XyrusB2010/XYmatics-Alpha/(list of files, cad)

Other CAD files:
CAD/XYmatics-Alpha.f3d
