XyrusB2010/XYmatics-Alpha/PCB/xymatics-e64.pdf

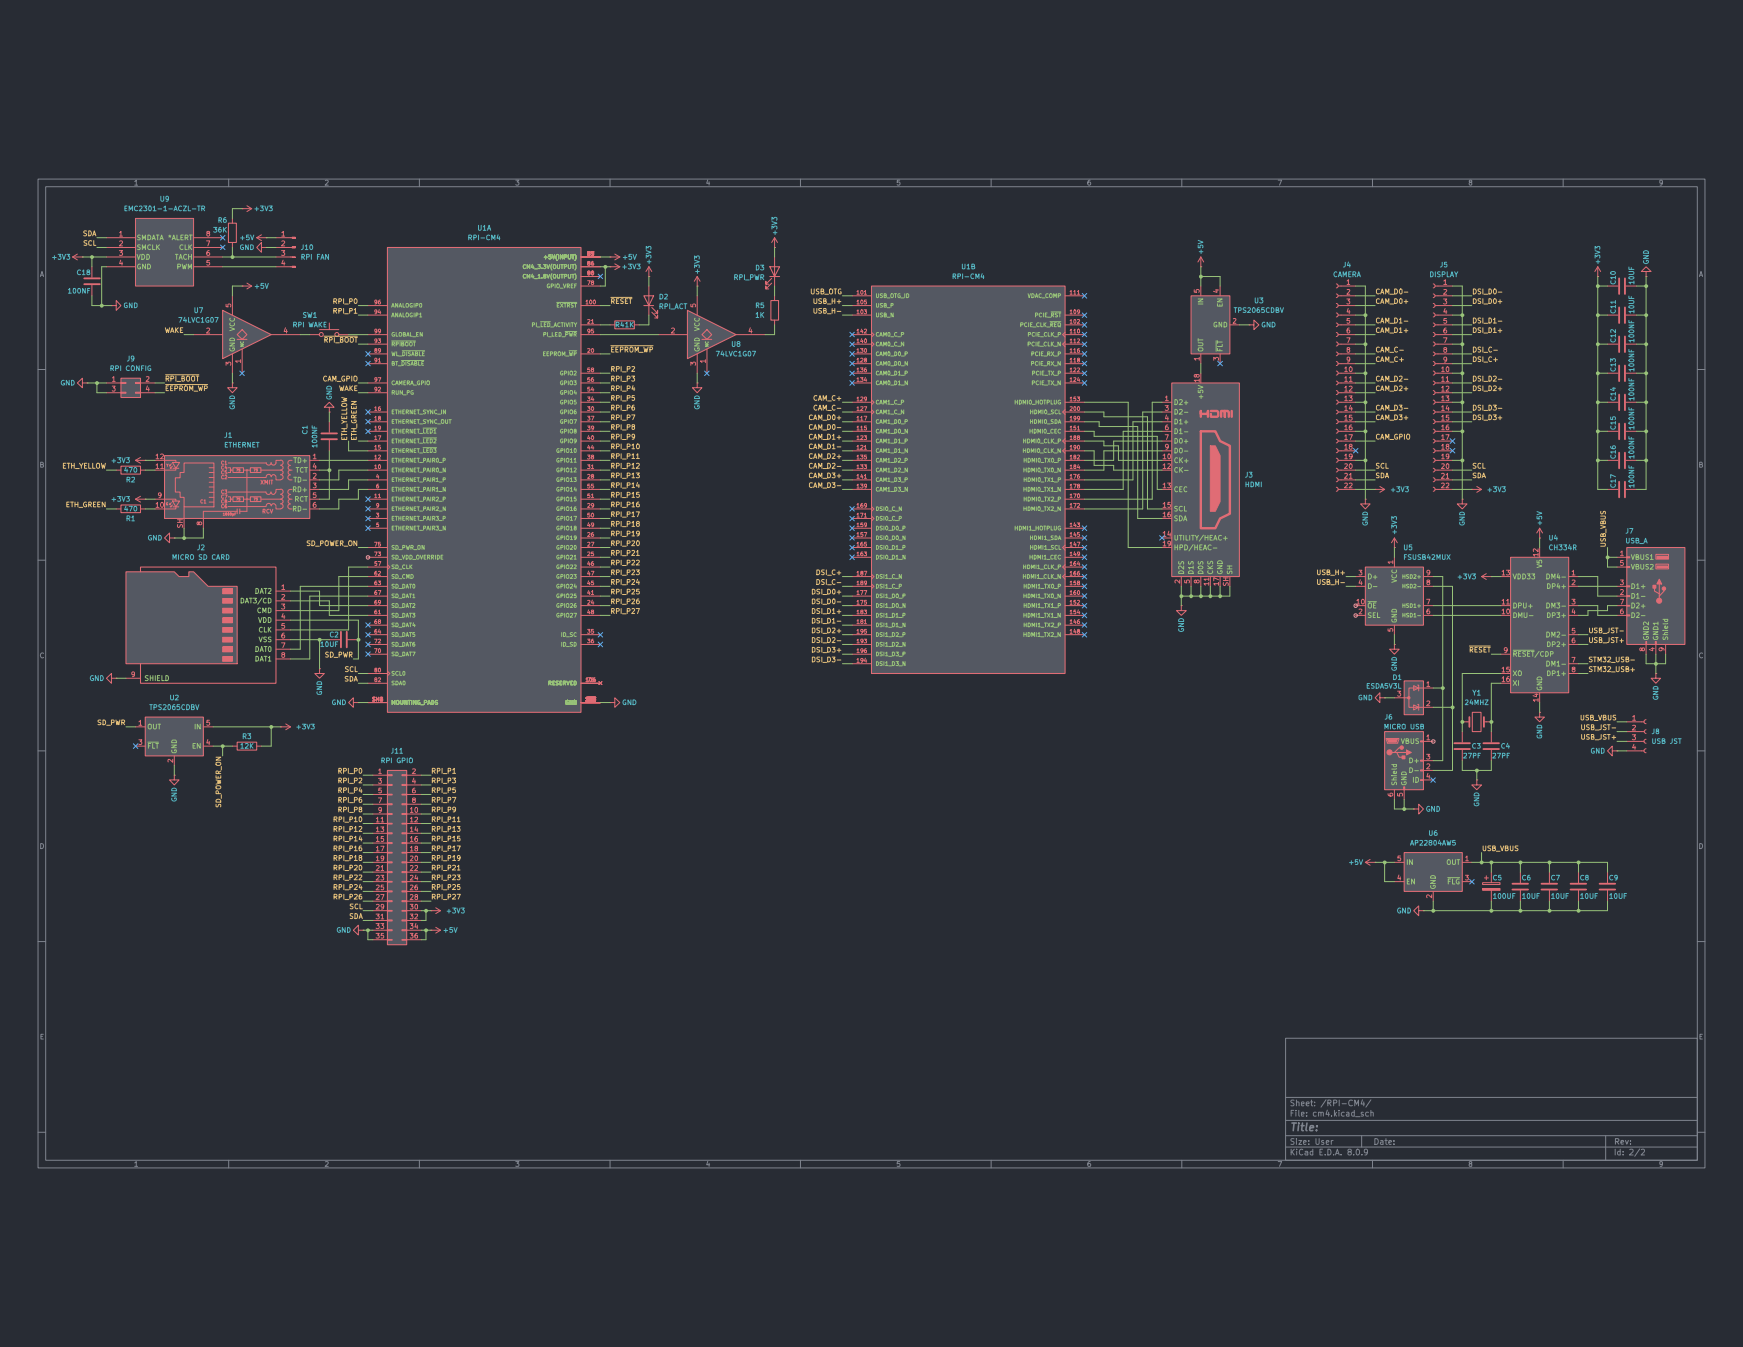
[picture p1: page 1]
