XyrusB2010/XYmatics-Alpha/PCB/cm4.kicad_sch

## KiCad design PCB/cm4.kicad_sch (2025-07-07)

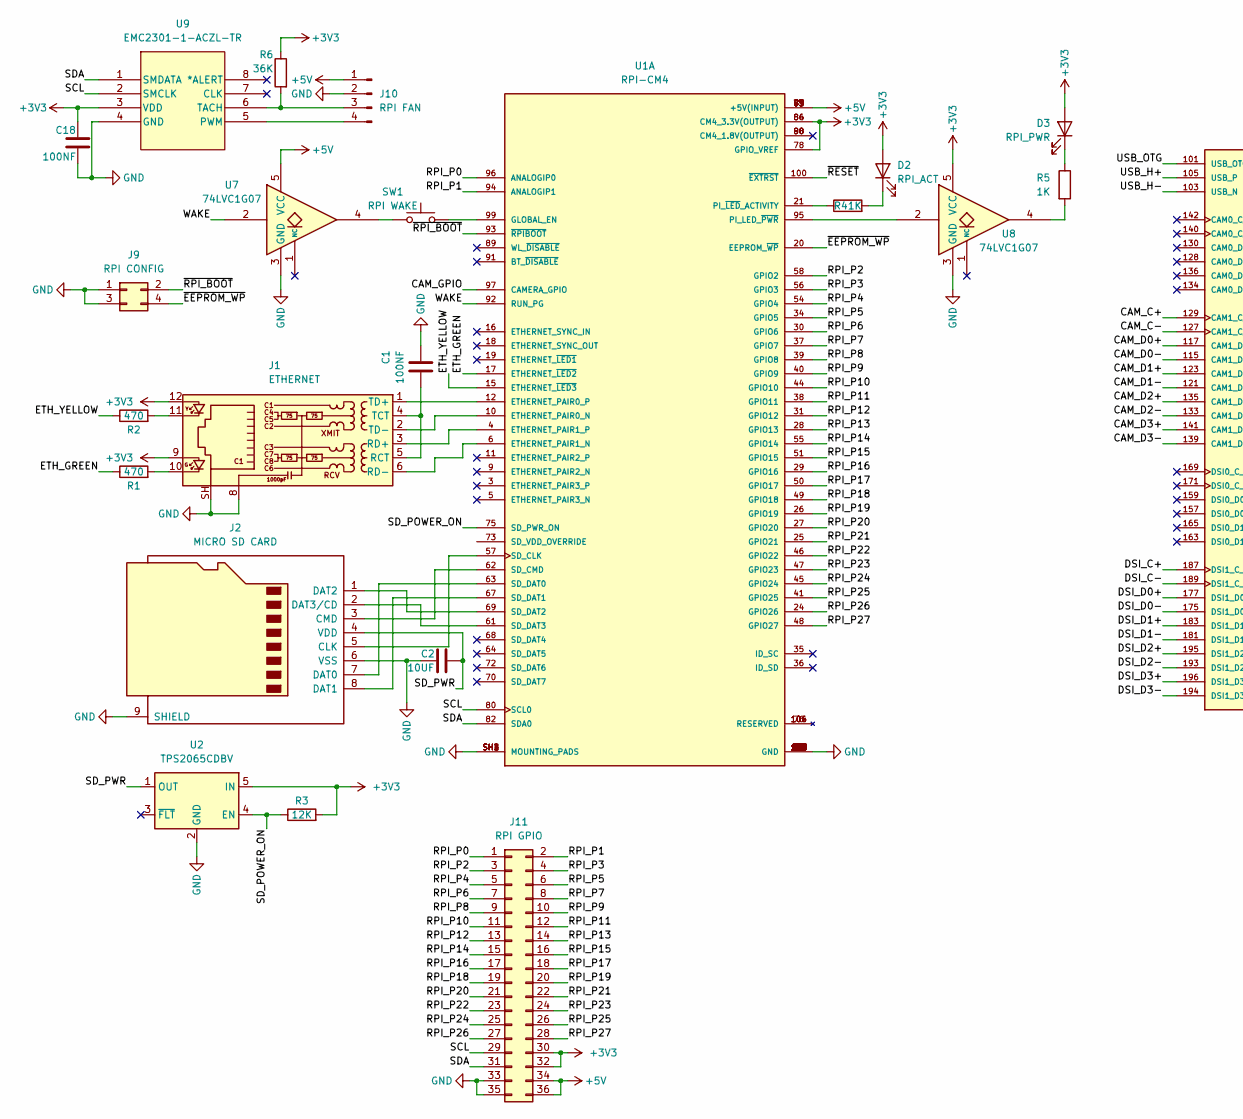
[picture p2: schematic cm4.kicad_sch, part in row 1, column 1]

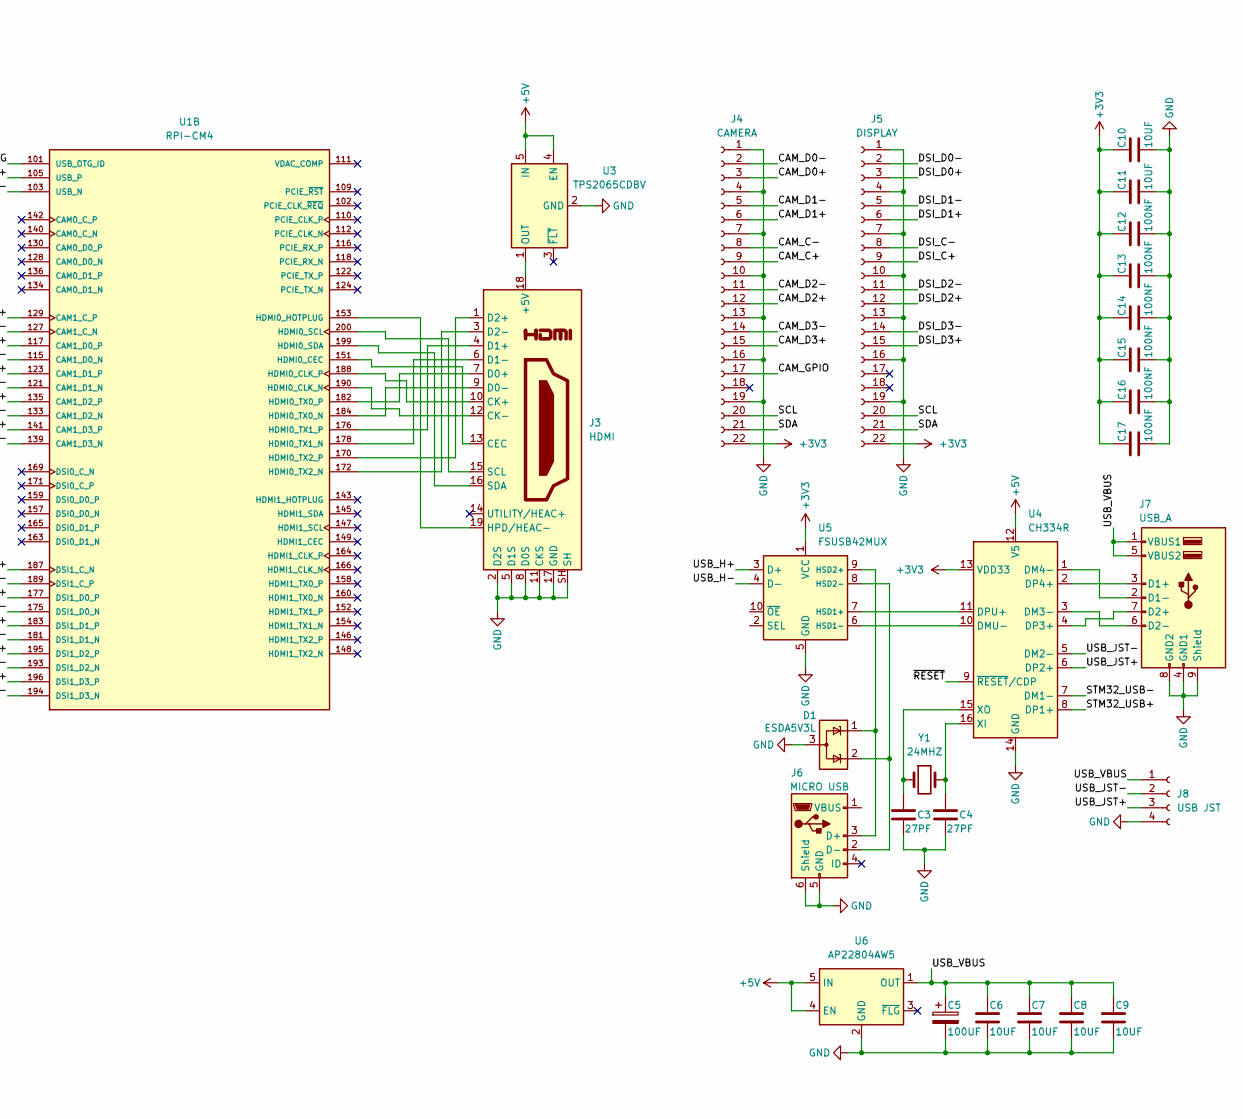
[picture p3: schematic cm4.kicad_sch, part in row 1, column 2]

Parts:
C1, C12, C13, C14, C15, C16, C17, C18: 100NF
C2, C6, C7, C8, C9, C10, C11: 10UF
C3, C4: 27PF
C5: 100UF
D1: ESDA5V3L; SOT-23-3
D2: RPI_ACT
D3: RPI_PWR
J1: ETHERNET; RJ45_Hanrun_HR911105A_Horizontal
J2: MICRO SD CARD
J3: HDMI
J4: CAMERA
J5: DISPLAY
J6: MICRO USB
J7: USB_A
J8: USB JST; JST_XH_B4B-XH-A_1x04_P2.50mm_Vertical
J9: RPI CONFIG; PinHeader_2x02_P2.54mm_Vertical
J10: RPI FAN; PinHeader_1x04_P2.54mm_Vertical
J11: RPI GPIO
R1, R2: 470
R3: 12K
R4, R5: 1K
R6: 36K
SW1: RPI WAKE
U1: RPI-CM4; MODULE_CM4102008; PARTREV 2021-10-12
U2, U3: TPS2065CDBV; SOT-23-5
U4: CH334R; QSOP-16_3.9x4.9mm_P0.635mm
U5: FSUSB42MUX; MSOP-10_3x3mm_P0.5mm
U6: AP22804AW5; SOT-23-5
U7, U8: 74LVC1G07
U9: EMC2301-1-ACZL-TR; MSOP8_MC_MCH
Y1: 24MHZ

Connections:
+3V3: C10.1, C11.1, C12.1, C13.1, C14.1, C15.1, C16.1, C17.1, C18.1, D2.2 (A), D3.2 (A), J1.9, J1.12, J4.22, J5.22, J11.30, J11.32, R3.2, R6.1, U1.78 (GPIO_VREF), U1.84 (CM4_3.3V(OUTPUT)), U1.86 (CM4_3.3V(OUTPUT)), U2.5 (IN), U4.13 (VDD33), U5.1 (VCC), U8.5 (VCC), U9.3 (VDD)
+5V: J10.1, J11.34, J11.36, U1.77 (+5V(INPUT)), U1.79 (+5V(INPUT)), U1.81 (+5V(INPUT)), U1.83 (+5V(INPUT)), U1.85 (+5V(INPUT)), U1.87 (+5V(INPUT)), U3.4 (EN), U3.5 (IN), U4.12 (V5), U6.4 (EN), U6.5 (IN), U7.5 (VCC)
CAM_C+: J4.9, U1.129 (CAM1_C_P)
CAM_C-: J4.8, U1.127 (CAM1_C_N)
CAM_D0+: J4.3, U1.117 (CAM1_D0_P)
CAM_D0-: J4.2, U1.115 (CAM1_D0_N)
CAM_D1+: J4.6, U1.123 (CAM1_D1_P)
CAM_D1-: J4.5, U1.121 (CAM1_D1_N)
CAM_D2+: J4.12, U1.135 (CAM1_D2_P)
CAM_D2-: J4.11, U1.133 (CAM1_D2_N)
CAM_D3+: J4.15, U1.141 (CAM1_D3_P)
CAM_D3-: J4.14, U1.139 (CAM1_D3_N)
CAM_GPIO: J4.17, U1.97 (CAMERA_GPIO)
DSI_C+: J5.9, U1.187 (DSI1_C_N)
DSI_C-: J5.8, U1.189 (DSI1_C_P)
DSI_D0+: J5.3, U1.177 (DSI1_D0_P)
DSI_D0-: J5.2, U1.175 (DSI1_D0_N)
DSI_D1+: J5.6, U1.183 (DSI1_D1_P)
DSI_D1-: J5.5, U1.181 (DSI1_D1_N)
DSI_D2+: J5.12, U1.195 (DSI1_D2_P)
DSI_D2-: J5.11, U1.193 (DSI1_D2_N)
DSI_D3+: J5.15, U1.196 (DSI1_D3_P)
DSI_D3-: J5.14, U1.194 (DSI1_D3_N)
ETH_GREEN: R1.1, U1.17 (ETHERNET_~LED2)
ETH_YELLOW: R2.1, U1.15 (ETHERNET_~LED3)
GND: C1.1, C2.2, C3.2, C4.2, C5.2, C6.2, C7.2, C8.2, C9.2, C10.2, C11.2, C12.2, C13.2, C14.2, C15.2, C16.2, C17.2, C18.2, D1.3 (A), J1.8, J1.SH, J2.6 (VSS), J2.9 (SHIELD), J3.2 (D2S), J3.5 (D1S), J3.8 (D0S), J3.11 (CKS), J3.17 (GND), J3.SH, J4.1, J4.4, J4.7, J4.10, J4.13, J4.16, J4.19, J5.1, J5.4, J5.7, J5.10, J5.13, J5.16, J5.19, J6.5 (GND), J6.6 (Shield), J7.4 (GND1), J7.8 (GND2), J7.9 (Shield), J8.4, J9.1, J9.3, J10.2, J11.33, J11.35, U1.1 (GND), U1.2 (GND), U1.7 (GND), U1.8 (GND), U1.13 (GND), U1.14 (GND), U1.22 (GND), U1.23 (GND), U1.32 (GND), U1.33 (GND), U1.42 (GND), U1.43 (GND), U1.52 (GND), U1.53 (GND), U1.59 (GND), U1.60 (GND), U1.65 (GND), U1.66 (GND), U1.71 (GND), U1.74 (GND), U1.98 (GND), U1.107 (GND), U1.108 (GND), U1.113 (GND), U1.114 (GND), U1.119 (GND), U1.120 (GND), U1.125 (GND), U1.126 (GND), U1.131 (GND), U1.132 (GND), U1.137 (GND), U1.138 (GND), U1.144 (GND), U1.150 (GND), U1.155 (GND), U1.156 (GND), U1.161 (GND), U1.162 (GND), U1.167 (GND), U1.168 (GND), U1.173 (GND), U1.174 (GND), U1.179 (GND), U1.180 (GND), U1.185 (GND), U1.186 (GND), U1.191 (GND), U1.192 (GND), U1.197 (GND), U1.198 (GND), U1.SH1 (MOUNTING_PADS), U1.SH2 (MOUNTING_PADS), U1.SH3 (MOUNTING_PADS), U1.SH4 (MOUNTING_PADS), U2.2 (GND), U3.2 (GND), U4.14 (GND), U5.5 (GND), U6.2 (GND), U7.3 (GND), U8.3 (GND), U9.4 (GND)
unnamed: C1.2, J1.4 (TCT), J1.5 (RCT)
unnamed: C3.1, U4.15 (XO), Y1.1
unnamed: C4.1, U4.16 (XI), Y1.2
unnamed: D1.1 (K), J6.3 (D+), U5.9 (HSD2+)
unnamed: D1.2 (K), J6.2 (D-), U5.8 (HSD2-)
unnamed: D2.1 (K), R4.2
unnamed: D3.1 (K), R5.1
unnamed: J1.1 (TD+), U1.12 (ETHERNET_PAIR0_P)
unnamed: J1.2 (TD-), U1.10 (ETHERNET_PAIR0_N)
unnamed: J1.3 (RD+), U1.4 (ETHERNET_PAIR1_P)
unnamed: J1.6 (RD-), U1.6 (ETHERNET_PAIR1_N)
unnamed: J1.10, R1.2
unnamed: J1.11, R2.2
unnamed: J2.1 (DAT2), U1.69 (SD_DAT2)
unnamed: J2.2 (DAT3/CD), U1.61 (SD_DAT3)
unnamed: J2.3 (CMD), U1.62 (SD_CMD)
unnamed: J2.5 (CLK), U1.57 (SD_CLK)
unnamed: J2.7 (DAT0), U1.63 (SD_DAT0)
unnamed: J2.8 (DAT1), U1.67 (SD_DAT1)
unnamed: J3.1 (D2+), U1.170 (HDMI0_TX2_P)
unnamed: J3.3 (D2-), U1.172 (HDMI0_TX2_N)
unnamed: J3.4 (D1+), U1.176 (HDMI0_TX1_P)
unnamed: J3.6 (D1-), U1.178 (HDMI0_TX1_N)
unnamed: J3.7 (D0+), U1.182 (HDMI0_TX0_P)
unnamed: J3.9 (D0-), U1.184 (HDMI0_TX0_N)
unnamed: J3.10 (CK+), U1.188 (HDMI0_CLK_P)
unnamed: J3.12 (CK-), U1.190 (HDMI0_CLK_N)
unnamed: J3.13 (CEC), U1.151 (HDMI0_CEC)
unnamed: J3.15 (SCL), U1.200 (HDMI0_SCL)
unnamed: J3.16 (SDA), U1.199 (HDMI0_SDA)
unnamed: J3.18 (+5V), U3.1 (OUT)
unnamed: J3.19 (HPD/HEAC-), U1.153 (HDMI0_HOTPLUG)
unnamed: J7.2 (D1-), U4.1 (DM4-)
unnamed: J7.3 (D1+), U4.2 (DP4+)
unnamed: J7.6 (D2-), U4.3 (DM3-)
unnamed: J7.7 (D2+), U4.4 (DP3+)
unnamed: J10.3, R6.2, U9.6 (TACH)
unnamed: J10.4, U9.5 (PWM)
unnamed: R4.1, U1.21 (PI_~LED_ACTIVITY)
unnamed: R5.2, U8.4
unnamed: SW1.1, U1.99 (GLOBAL_EN)
unnamed: SW1.2, U7.4
unnamed: U1.88 (CM4_1.8V(OUTPUT)), U1.90 (CM4_1.8V(OUTPUT))
unnamed: U1.95 (PI_LED_~PWR), U8.2
unnamed: U1.76 (RESERVED), U1.104 (RESERVED), U1.106 (RESERVED)
unnamed: U4.10 (DMU-), U5.6 (HSD1-)
unnamed: U4.11 (DPU+), U5.7 (HSD1+)
RPI_P0: J11.1, U1.96 (ANALOGIP0)
RPI_P1: J11.2, U1.94 (ANALOGIP1)
RPI_P2: J11.3, U1.58 (GPIO2)
RPI_P3: J11.4, U1.56 (GPIO3)
RPI_P4: J11.5, U1.54 (GPIO4)
RPI_P5: J11.6, U1.34 (GPIO5)
RPI_P6: J11.7, U1.30 (GPIO6)
RPI_P7: J11.8, U1.37 (GPIO7)
RPI_P8: J11.9, U1.39 (GPIO8)
RPI_P9: J11.10, U1.40 (GPIO9)
RPI_P10: J11.11, U1.44 (GPIO10)
RPI_P11: J11.12, U1.38 (GPIO11)
RPI_P12: J11.13, U1.31 (GPIO12)
RPI_P13: J11.14, U1.28 (GPIO13)
RPI_P14: J11.15, U1.55 (GPIO14)
RPI_P15: J11.16, U1.51 (GPIO15)
RPI_P16: J11.17, U1.29 (GPIO16)
RPI_P17: J11.18, U1.50 (GPIO17)
RPI_P18: J11.19, U1.49 (GPIO18)
RPI_P19: J11.20, U1.26 (GPIO19)
RPI_P20: J11.21, U1.27 (GPIO20)
RPI_P21: J11.22, U1.25 (GPIO21)
RPI_P22: J11.23, U1.46 (GPIO22)
RPI_P23: J11.24, U1.47 (GPIO23)
RPI_P24: J11.25, U1.45 (GPIO24)
RPI_P25: J11.26, U1.41 (GPIO25)
RPI_P26: J11.27, U1.24 (GPIO26)
RPI_P27: J11.28, U1.48 (GPIO27)
SCL: J4.20, J5.20, J11.29, U1.80 (SCL0), U9.2 (SMCLK)
SDA: J4.21, J5.21, J11.31, U1.82 (SDA0), U9.1 (SMDATA)
SD_POWER_ON: R3.1, U1.75 (SD_PWR_ON), U2.4 (EN)
SD_PWR: C2.1, J2.4 (VDD), U2.1 (OUT)
STM32_USB+: U4.8 (DP1+)
STM32_USB-: U4.7 (DM1-)
USB_H+: U1.105 (USB_P), U5.3 (D+)
USB_H-: U1.103 (USB_N), U5.4 (D-)
USB_JST+: J8.3, U4.6 (DP2+)
USB_JST-: J8.2, U4.5 (DM2-)
USB_OTG: U1.101 (USB_OTG_ID)
USB_VBUS: C5.1, C6.1, C7.1, C8.1, C9.1, J7.1 (VBUS1), J7.5 (VBUS2), J8.1, U6.1 (OUT)
WAKE: U1.92 (RUN_PG), U7.2
~EEPROM_WP: J9.4, U1.20 (EEPROM_~WP)
~RESET: U1.100 (~EXTRST), U4.9 (~RESET/CDP)
~RPI_BOOT: J9.2, U1.93 (~RPIBOOT)
