XyrusB2010/XYmatics-Alpha/(commit log)

2025-06-16 Add XYmatics-Alpha CAD file
    Base frame with brackets
    [XYmatics-Alpha.f3d]
2025-06-16 Update JOURNAL.md
    Added image of frame
2025-06-17 Update JOURNAL.md
    17/06/2025 - Complete frame and start motion system
2025-07-07 Add CM4 schematic to PCB
    [cm4.kicad_sch, xymatics-e64.kicad_pcb]
2025-07-07 Add PDF of PCB schematic
2025-07-07 Update JOURNAL.md
    7/07/2025 - Begin electronics and PCB
